jdfin/desktop_train/arduino/CommandStation-EX/Release - Architecture Doc/CommandStation-EX-Arch-v1-0.pdf

## DCC-EX CommandStation-EX Architecture (CS-EX) v3.0.0 Drawing v1-0 - 25-Nov-2020

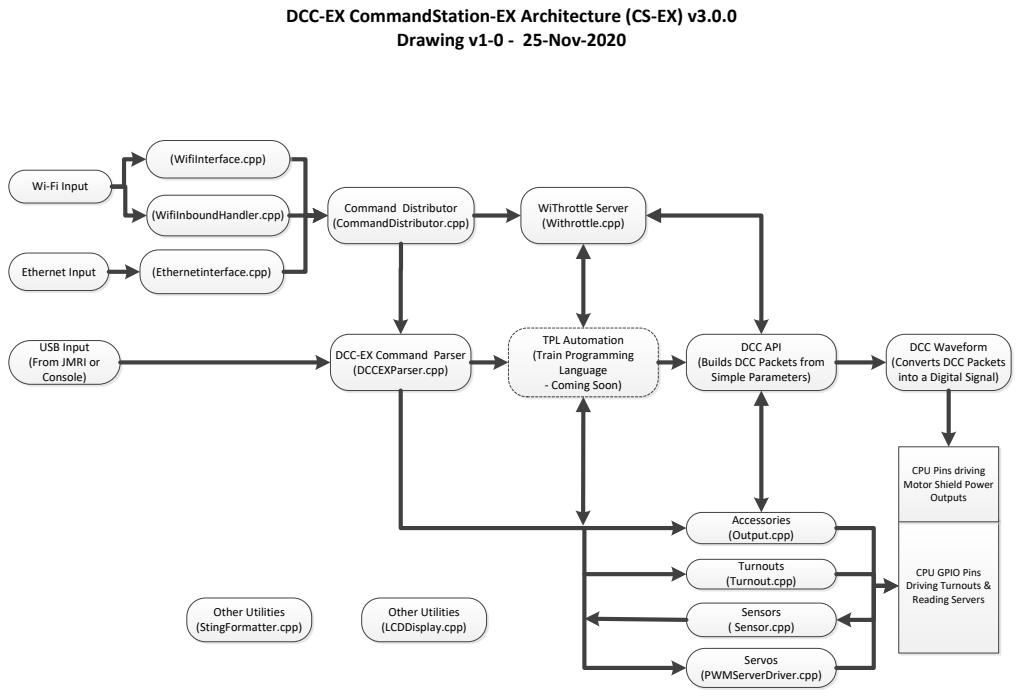
[picture p4: page 1]
(WifiInboundHandler.cpp); Ethernet Input; DCC API; (Ethernetinterface.cpp); Reading Servers; (WifiInterface.cpp)

Wi-Fi Input

Command Distributor (CommandDistributor.cpp) (https://github.com/DCC-EX/CommandStation-EX/blob/master/CommandDistributor.cpp)

WiThrottle Server (Withrottle.cpp) (https://github.com/DCC-EX/CommandStation-EX/blob/master/WiThrottle.cpp)

TPL Automation (Train Programming

USB Input
(From JMRI or Console)

DCC Waveform (Converts DCC Packets into a Digital Signal) (https://github.com/DCC-EX/CommandStation-EX/blob/master/DCCWaveform.cpp)

DCC-EX Command Parser (DCCEXParser.cpp) (https://github.com/DCC-EX/CommandStation-EX/blob/master/DCCEXParser.cpp)

(Builds DCC Packets from Simple Parameters) (https://github.com/DCC-EX/CommandStation-EX/blob/master/DCC.cpp)

Language - Coming Soon)

CPU Pins driving
Motor Shield Power Outputs

Accessories (Output.cpp) (https://github.com/DCC-EX/CommandStation-EX/blob/master/Outputs.cpp)

Turnouts (Turnout.cpp) (https://github.com/DCC-EX/CommandStation-EX/blob/master/Turnouts.cpp)

CPU GPIO Pins Driving Turnouts &

Other Utilities (StingFormatter.cpp) (https://github.com/DCC-EX/CommandStation-EX/blob/master/StringFormatter.cpp)

Other Utilities (LCDDisplay.cpp) (https://github.com/DCC-EX/CommandStation-EX/blob/master/LCDDisplay.cpp)

Sensors ( Sensor.cpp) (https://github.com/DCC-EX/CommandStation-EX/blob/master/Sensors.cpp)

Servos (PWMServerDriver.cpp) (https://github.com/DCC-EX/CommandStation-EX/blob/master/PWMServoDriver.cpp)
