jdfin/desktop_train/arduino/CommandStation-EX/myAutomation.h

#include "myAutomation_loco.h"
#include "myAutomation_layout.h"
#include "myAutomation_actions.h"

// Pick one of the following

#include "myAutomation_ops.h"
//#include "myAutomation_rgb.h"
//#include "myAutomation_screen.h"
//#include "myAutomation_spur1.h"
//#include "myAutomation_turnouts.h"
