jdfin/desktop_train/(commit log)

2024-10-24 add spur spot check and retry
    If the car happens to couple to the loco during a spot, detect it
    and retry starting with the uncouple.
    This seems to happen occasionally when spotting the tank car to
    spur 2, perhaps due to the s-curve it has to go through.
2024-10-24 fix typos in spot retry logic
    [myAutomation_actions.h]
